calstar/iris-core-hw/README.md

View this project on [CADLAB.io](https://cadlab.io/project/23494). 

# iris-core-hw
