calstar/iris-core-hw/IRIS-core/IRIS_bom.xlsx

ITEM TO PURCHASE FROM DIGIKEY (IRIS CORE)
 | References | Digikey P/N | Value | Footprint | Quantity
1 | COR-BT1 | 36-500-ND | CR1220 - Keystone 500 | CR12XX-Keystone-500 | 1
2 | COR-C1 | 1276-1069-1-ND | 10pF | C_0603_1608Metric | 1
3 | COR-C2, COR-C6, COR-C7, COR-C8 | 1276-CL10B104KB8NNNLCT-ND | 0.1uF | C_0603_1608Metric | 4
4 | COR-C3 | 1276-1192-1-ND | 10uF | C_0603_1608Metric | 1
5 | COR-C4 | 478-10428-1-ND | 20nF | C_0805_2012Metric | 1
6 | COR-C5 | RMCF0603ZT0R00CT-ND | 0R | C_0603_1608Metric | 1
7 | COR-C9 | 1276-1102-1-ND | 1uF | C_0603_1608Metric | 1
8 | COR-D1, COR-D2 | MBR0540T3GOSCT-ND | MBR0540 | D_SOD-123 | 2
9 | COR-D3 | 732-4984-1-ND | 150080RS75000 | LED_0805_2012Metric_Pad1.15x1.40mm_HandSolder | 1
10 | COR-D4 | 732-4986-1-ND | 150080VS75000 | LED_0805_2012Metric_Pad1.15x1.40mm_HandSolder | 1
11 | COR-D5 | 732-4987-1-ND | 150080YS75000 | LED_0805_2012Metric_Pad1.15x1.40mm_HandSolder | 1
12 | COR-FB1 | 732-1593-1-ND | 600 | L_0603_1608Metric | 1
14 | COR-JP2 | 2057-PH1RB-02-UA-ND | Write_Protect | PinHeader_1x02_P2.54mm_Horizontal | 1
15 | COR-R1, COR-R2, COR-R5, COR-R6, COR-R11, COR-R12, COR-R13, COR-R14 | RNCP0603FTD10K0CT-ND | 10k | R_0603_1608Metric | 8
16 | COR-R10, COR-R20, COR-R21 | RMCF0603ZT0R00CT-ND | 0R | R_0603_1608Metric | 3
17 | COR-R15, COR-R16, COR-R17 | RMCF0603FT100RCT-ND | 100R | R_0603_1608Metric | 3
19 | COR-R3 | RMCF0603FT1K00CT-ND | 1k | R_0603_1608Metric | 1
20 | COR-R4 | P249BLCT-ND | 249R | R_0603_1608Metric | 1
21 | COR-R7, COR-R8 | RR08P100KDCT-ND | 100k | R_0603_1608Metric | 2
22 | COR-R9 | RR08P24.9KDCT-ND | 24.9k | R_0603_1608Metric | 1
23 | COR-SW1 | CKN9103-ND | SW_Push | SW_Tactile_SPST_Angled_PTS645Vx39-2LFS | 1
24 | COR-TP1 | 36-5006-ND | Raw | TestPoint_Keystone_5005-5009_Compact | 1
25 | COR-TP2 | 36-5006-ND | Amplified | TestPoint_Keystone_5005-5009_Compact | 1
29 | COR-U3 | LT1807IS8#TRPBFCT-ND | LT1807 | SOIC-8_3.9x4.9mm_P1.27mm | 1
30 | COR-U4 | 557-1789-ND | MT25QL01GBBB8ESF-0SIT | SOIC-16W_7.5x10.3mm_P1.27mm | 1
31 | COR-U5 | 1127-3597-ND | EVAL-ADXL372Z | EVAL-ADXL372Z | 1
33 | COR-U7, COR-U8, COR-U9 | 296-35965-1-ND | TPD4E1U06 | SOT-23-6 | 3
ITEM TO PURCHASE FROM DIGIKEY (IRIS POWER)
 | References | Digikey PN | Value | Footprint | Quantity
1 | C34, C71 | 1276-1102-1-ND | 1uF | C_0603_1608Metric | 2
2 | C31, C32, C33, C35, C41, C51, C52, C53, C54, C55, C56, C63, C72 | 1276-1192-1-ND | 10uF | C_0603_1608Metric | 13
3 | C43 | 1276-1814-1-ND | 68nF | C_0603_1608Metric | 1
4 | C44 | 1276-1951-1-ND | 1.2nF | C_0603_1608Metric | 1
5 | C45 | 1276-2025-1-ND | 27nF | C_0603_1608Metric | 1
6 | C65 | 1276-3063-1-ND | 47uF | C_1206_3216Metric | 1
7 | C46 | 1276-3387-1-ND | 10uF | C_0805_2012Metric | 1
8 | C21, C42, C64 | 1276-CL10B104KB8NNNLCT-ND | 0.1uF | C_0603_1608Metric | 3
9 | C61, C62 | 1572-DGH106Q2R7C-ND | 3.3F | CAP_10x27_5mm_pitch | 2
10 | C22, C47 | 587-3506-1-ND | 0.47uF | C_0603_1608Metric | 2
11 | R68 | 311-150KHRCT-ND | 150k | R_0603_1608Metric | 1
12 | R21 | 311-2595-1-ND | 499k | R_0603_1608Metric | 1
13 | R67 | 541-1.10MHCT-ND | 1.1M | R_0603_1608Metric | 1
14 | R25 | CST0612-FC-R002ECT-ND | 2m | CST0612-FC-R002E | 1
15 | R43 | P232KHCT-ND | 232k | R_0603_1608Metric | 1
16 | R65 | RMCF0603FG1M00CT-ND | 1M | R_0603_1608Metric | 1
17 | R32 | RMCF0603FT1K00CT-ND | 1k | R_0603_1608Metric | 1
18 | R35, R42 | RMCF0603FT38K3CT-ND | 38.3k | R_0603_1608Metric | 2
19 | R62, R66 | RMCF0603FT3K00CT-ND | 3k | R_0603_1608Metric | 2
20 | R64 | RMCF0603FT3M30CT-ND | 3.3M | R_0603_1608Metric | 1
21 | R24, R33, R44, R51, R61, R63, R69 | RNCP0603FTD10K0CT-ND | 10k | R_0603_1608Metric | 7
22 | R31, R34, R41, R52 | RNCP0603FTD2K49CT-ND | 2.49k | R_0603_1608Metric | 4
23 | R23 | RR08P200KDCT-ND | 200k | R_0603_1608Metric | 1
24 | R22 | RR08P301KDCT-ND | 301k | R_0603_1608Metric | 1
25 | L41 | 445-VLS6045AF-8R2MCT-ND | 8.2uH | VLS6045AF | 1
26 | L61 | 732-6178-1-ND | 1.5uH | 744316150 | 1
27 | D31, D41 | 641-1698-1-ND | D_Schottky | D_SMA_Handsoldering | 2
28 | U61 | Mail from Jason | LTC3110 | LTC3110 | 1
29 | U31 | Mail from Jason | TPS2121 | TPS2121 | 1
30 | U51 | From Mouser | TPSM53604 | TPSM53604 | 1
31 | U21 | 175-MAX17261METD+TCT-ND | MAX17261 | MAX17261 | 1
32 | U41 | Mail from Jason | TPS55340 | TPS55340 | 1
33 | U71 | 296-50414-1-ND | TLV75733PDBV | SOT-23-5 | 1
34 | U62 | 568-1837-1-ND | PCA9537 | TSSOP-10_3x3mm_P0.5mm | 1
35 | JP41, JP42 |  | Jumper_3_Bridged12 | PinHeader_1x03_P2.54mm_Vertical | 2
37 | Q21 | 1727-8643-1-ND | 2N7002 | SOT-23 | 1
38 | TP61 | 36-5006-ND | Vcap | TestPoint_Keystone_5000-5004_Miniature | 1
39 | TP101 | 36-5006-ND | Jack | TestPoint_Keystone_5000-5004_Miniature | 1
40 | TP102 | 36-5006-ND | Mux | TestPoint_Keystone_5000-5004_Miniature | 1
41 | TP103 | 36-5006-ND | #NAME? | TestPoint_Keystone_5000-5004_Miniature | 1
42 | TP104 | 36-5006-ND | 5V | TestPoint_Keystone_5000-5004_Miniature | 1
43 | TP105 | 36-5006-ND | 29.5V | TestPoint_Keystone_5000-5004_Miniature | 1
44 | TP106 | 36-5006-ND | Backup | TestPoint_Keystone_5000-5004_Miniature | 1
45 | TP107 | 36-5006-ND | 3.3V | TestPoint_Keystone_5000-5004_Miniature | 1
46 | Q61 | DMP2066LSNDICT-ND | DMP2066LSN-7 | SOT-23 | 1
47 | J11 | 2243-1336G1-ND | Powerpole | Powerpole_1336G1 | 1
48 | J12 | CP-047AH-ND | PJ-047AH | CUI_PJ-047AH | 1
ITEMS TO PURCHASE FROM OTHER VENDOR
 | U2 | https://www.tindie.com/products/onehorse/all-st-motion-sensor-breakout-board/ | ST_MOTION_Breakout |  | 1
Connectors to Purchase / Sample
 | Part Number | Digikey P/N | Mouser P/N | Notes | Quantity
 | TLW-105-06-T-S | SAM1101-05-ND |  | 2 for ADXL372 board, 2 for IMU breakout, 2 for Teensy 4.1 | 6
 | SLW-105-01-T-S | SAM1093-05-ND |  | 2 for ADXL372 board, 2 for IMU breakout, 2 for Teensy 4.1 | 6
 | SSW-103-01-G-D | SAM1208-03-ND |  | 2 for 2 scintillator boards | 2
 | TLW-124-06-T-S |  | 200-TLW12406TS | Recommend sample from samtec, 4 for Teensy 4.1 | 4
 | SLW-124-01-T-S | SAM1093-24-ND |  | 4 for Teensy 4.1 (2 teensy for 2 boards?) | 4
 | ESQ-120-24-T-S |  | 200-ESQ12024TS | 1 for middle board | 1
 | TSW-120-18-L-S |  | 200-TSW12018LS | 1 for top board | 1
 | SSW-120-02-G-S |  | 200-SSW12002GS | 1 for bottom board | 1
