calstar/iris-core-hw/IRIS-core/IRIS-core.kicad_pcb

## KiCad design IRIS-core/IRIS-core.kicad_pcb (2020-11-06)

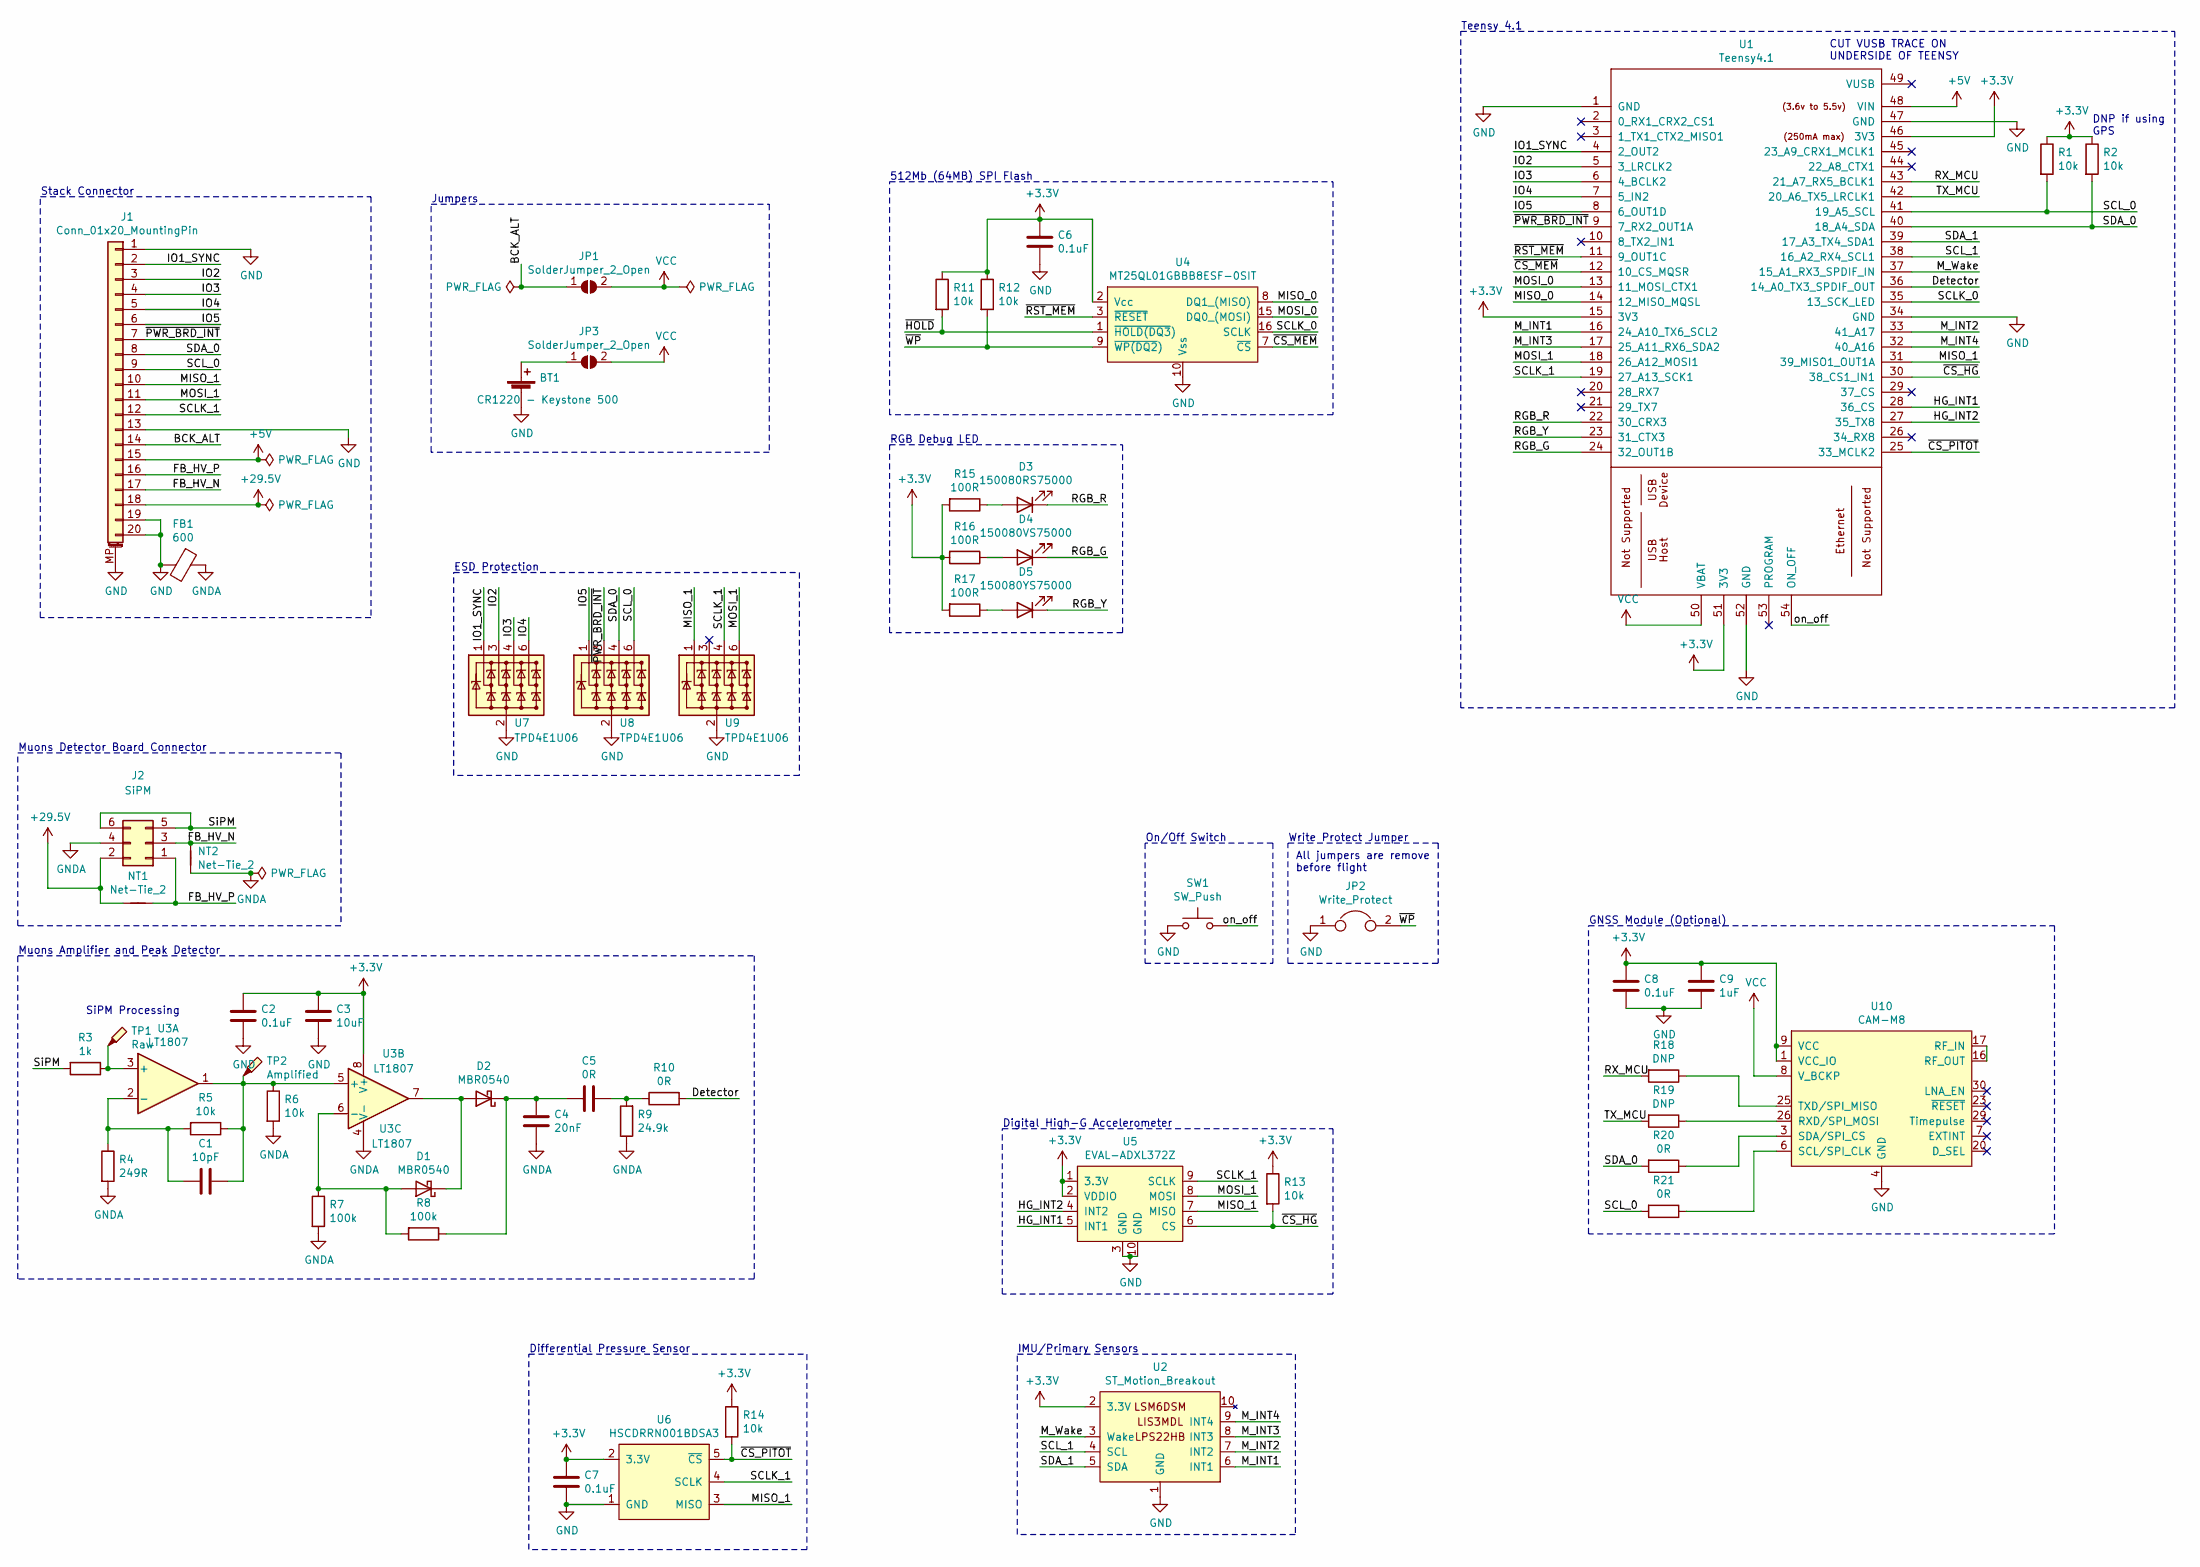
[picture p1: schematic IRIS-core.sch]

Parts:
BT1: CR1220 - Keystone 500; CR12XX-Keystone-500; Digikey P/N 36-500-ND
C1: 10pF; C_0603_1608Metric; Digikey P/N 1276-1069-1-ND
C2, C6, C7, C8: 0.1uF; C_0603_1608Metric; Digikey P/N 1276-CL10B104KB8NNNLCT-ND
C3: 10uF; C_0603_1608Metric; Digikey P/N 1276-1192-1-ND
C4: 20nF; C_0805_2012Metric; Digikey P/N 478-10428-1-ND
C5: 0R; C_0603_1608Metric; Digikey P/N RMCF0603ZT0R00CT-ND
C9: 1uF; C_0603_1608Metric; Digikey P/N 1276-1102-1-ND
D1, D2: MBR0540; D_SOD-123; Digikey P/N MBR0540T3GOSCT-ND
D3: 150080RS75000; LED_0805_2012Metric_Pad1.15x1.40mm_HandSolder; Digikey P/N 732-4984-1-ND
D4: 150080VS75000; LED_0805_2012Metric_Pad1.15x1.40mm_HandSolder; Digikey P/N 732-4986-1-ND
D5: 150080YS75000; LED_0805_2012Metric_Pad1.15x1.40mm_HandSolder; Digikey P/N 732-4987-1-ND
FB1: 600; L_0603_1608Metric; Digikey P/N 732-1593-1-ND
J1: Conn_01x20_MountingPin; IRIS_Muons_physical
J2: SiPM
JP1, JP3: SolderJumper_2_Open; SolderJumper-2_P1.3mm_Open_RoundedPad1.0x1.5mm
JP2: Write_Protect; PinHeader_1x02_P2.54mm_Horizontal; Digikey P/N 2057-PH1RB-02-UA-ND
NT1, NT2: Net-Tie_2; NetTie-2_SMD_Pad0.5mm
R1, R2, R5, R6, R11, R12, R13, R14: 10k; R_0603_1608Metric; Digikey P/N RNCP0603FTD10K0CT-ND
R3: 1k; R_0603_1608Metric; Digikey P/N RMCF0603FT1K00CT-ND
R4: 249R; R_0603_1608Metric; Digikey P/N P249BLCT-ND
R7, R8: 100k; R_0603_1608Metric; Digikey P/N RR08P100KDCT-ND
R9: 24.9k; R_0603_1608Metric; Digikey P/N RR08P24.9KDCT-ND
R10, R20, R21: 0R; R_0603_1608Metric; Digikey P/N RMCF0603ZT0R00CT-ND
R15, R16, R17: 100R; R_0603_1608Metric; Digikey P/N RMCF0603FT100RCT-ND
R18, R19: DNP; R_0603_1608Metric
SW1: SW_Push; SW_Tactile_SPST_Angled_PTS645Vx39-2LFS; Digikey P/N CKN9103-ND
TP1: Raw; TestPoint_Keystone_5005-5009_Compact; Digikey P/N 36-5006-ND
TP2: Amplified; TestPoint_Keystone_5005-5009_Compact; Digikey P/N 36-5006-ND
U1: Teensy4.1; Teensy41
U2: ST_Motion_Breakout
U3: LT1807; SOIC-8_3.9x4.9mm_P1.27mm; Digikey P/N LT1807IS8#TRPBFCT-ND
U4: MT25QL01GBBB8ESF-0SIT; SOIC-16W_7.5x10.3mm_P1.27mm; Digikey P/N 557-1789-ND
U5: EVAL-ADXL372Z; Digikey P/N 1127-3597-ND
U6: HSCDRRN001BDSA3
U7, U8, U9: TPD4E1U06; SOT-23-6; Digikey P/N 296-35965-1-ND
U10: CAM-M8; UBLOX_CAM_M8; Digikey P/N 672-CAM-M8Q-0TR-ND

Connections:
+3V3: C2.1, C3.1, C6.1, C7.1, C8.1, C9.1, R1.1, R2.1, R11.1, R12.1, R13.1, R14.1, R15.2, R16.2, R17.2, U1.15 (3V3), U1.46 (3V3), U1.51 (3V3), U2.2 (3.3V), U3.8 (V+), U4.2 (Vcc), U5.1 (3.3V), U5.2 (VDDIO), U6.2 (3.3V), U10.1 (VCC_IO), U10.9 (VCC)
+5V: J1.15, U1.48 (VIN)
+29.5V: J1.18, J2.2, NT1.2
/BCK_ALT: J1.14, JP1.1 (A)
/Detector: R10.2, U1.36 (14_A0_TX3_SPDIF_OUT)
/FB_HV_N: J1.17, J2.3, NT2.1
/FB_HV_P: J1.16, J2.1, NT1.1
/HG_INT1: U1.28 (36_CS), U5.5 (INT1)
/HG_INT2: U1.27 (35_TX8), U5.4 (INT2)
/IO1_SYNC: J1.2, U1.4 (2_OUT2), U7.1 (IO1)
/IO2: J1.3, U1.5 (3_LRCLK2), U7.3 (IO2)
/IO3: J1.4, U1.6 (4_BCLK2), U7.4 (IO3)
/IO4: J1.5, U1.7 (5_IN2), U7.6 (IO4)
/IO5: J1.6, U1.8 (6_OUT1D), U8.1 (IO1)
/MISO_0: U1.14 (12_MISO_MQSL), U4.8 (DQ1_(MISO))
/MISO_1: J1.10, U1.31 (39_MISO1_OUT1A), U5.7 (MISO), U6.3 (MISO), U9.1 (IO1)
/MOSI_0: U1.13 (11_MOSI_CTX1), U4.15 (DQ0_(MOSI))
/MOSI_1: J1.11, U1.18 (26_A12_MOSI1), U5.8 (MOSI), U9.6 (IO4)
/M_INT1: U1.16 (24_A10_TX6_SCL2), U2.6 (INT1)
/M_INT2: U1.33 (41_A17), U2.7 (INT2)
/M_INT3: U1.17 (25_A11_RX6_SDA2), U2.8 (INT3)
/M_INT4: U1.32 (40_A16), U2.9 (INT4)
/M_Wake: U1.37 (15_A1_RX3_SPDIF_IN), U2.3 (Wake)
/RGB_G: D4.1 (K), U1.24 (32_OUT1B)
/RGB_R: D3.1 (K), U1.22 (30_CRX3)
/RGB_Y: D5.1 (K), U1.23 (31_CTX3)
/RX_MCU: R18.2, U1.43 (21_A7_RX5_BCLK1)
/SCLK_0: U1.35 (13_SCK_LED), U4.16 (SCLK)
/SCLK_1: J1.12, U1.19 (27_A13_SCK1), U5.9 (SCLK), U6.4 (SCLK), U9.4 (IO3)
/SCL_0: J1.9, R1.2, R21.2, U1.41 (19_A5_SCL), U8.6 (IO4)
/SCL_1: U1.38 (16_A2_RX4_SCL1), U2.4 (SCL)
/SDA_0: J1.8, R2.2, R20.2, U1.40 (18_A4_SDA), U8.4 (IO3)
/SDA_1: U1.39 (17_A3_TX4_SDA1), U2.5 (SDA)
/SiPM: J2.5, J2.6, R3.2
/TX_MCU: R19.2, U1.42 (20_A6_TX5_LRCLK1)
/on_off: SW1.2, U1.54 (ON_OFF)
/~CS_HG: R13.2, U1.30 (38_CS1_IN1), U5.6 (CS)
/~CS_MEM: U1.12 (10_CS_MQSR), U4.7 (~CS)
/~CS_PITOT: R14.2, U1.25 (33_MCLK2), U6.5 (~CS)
/~HOLD: R11.2, U4.1 (~HOLD(DQ3))
/~PWR_BRD_INT: J1.7, U1.9 (7_RX2_OUT1A), U8.3 (IO2)
/~RST_MEM: U1.11 (9_OUT1C), U4.3 (~RESET)
/~WP: JP2.2, R12.2, U4.9 (~WP(DQ2))
GND: BT1.2 (-), C2.2, C3.2, C6.2, C7.2, C8.2, C9.2, FB1.2, J1.1, J1.13, J1.19, J1.20, J1.MP (MountPin), JP2.1, SW1.1, U1.1 (GND), U1.34 (GND), U1.47 (GND), U1.52 (GND), U2.1 (GND), U4.10 (Vss), U5.3 (GND), U5.10 (GND), U6.1 (GND), U7.2 (GND), U8.2 (GND), U9.2 (GND), U10.4 (GND), U10.5 (GND), U10.10 (GND), U10.11 (GND), U10.12 (GND), U10.13 (GND), U10.14 (GND), U10.15 (GND), U10.18 (GND), U10.19 (GND), U10.21 (GND), U10.22 (GND), U10.27 (GND), U10.31 (GND)
GNDA: C4.2, FB1.1, J2.4, NT2.2, R4.2, R6.2, R7.2, R9.1, U3.4 (V-)
unnamed: BT1.1 (+), JP3.1 (A)
unnamed: C1.1, R5.1, R6.1, TP2.1, U3.1, U3.5 (+)
unnamed: C1.2, R4.1, R5.2, U3.2 (-)
unnamed: C4.1, C5.2, D2.1 (K), R8.1
unnamed: C5.1, R9.2, R10.1
unnamed: D1.1 (K), D2.2 (A), U3.7
unnamed: D1.2 (A), R7.1, R8.2, U3.6 (-)
unnamed: D3.2 (A), R15.1
unnamed: D4.2 (A), R16.1
unnamed: D5.2 (A), R17.1
unnamed: R3.1, TP1.1, U3.3 (+)
unnamed: R18.1, U10.25 (TXD/SPI_MISO)
unnamed: R19.1, U10.26 (RXD/SPI_MOSI)
unnamed: R20.1, U10.3 (SDA/SPI_CS)
unnamed: R21.1, U10.6 (SCL/SPI_CLK)
unnamed: U10.16 (RF_OUT), U10.17 (RF_IN)
VCC: JP1.2 (B), JP3.2 (B), U1.50 (VBAT), U10.8 (V_BCKP)

Notes on the sheet:
Digital High-G Accelerometer
512Mb (64MB) SPI Flash
IMU/Primary Sensors
RGB Debug LED
SiPM Processing
CUT VUSB TRACE ON UNDERSIDE OF TEENSY
All jumpers are remove before flight
DNP if using GPS
Teensy 4.1
GNSS Module (Optional)
Differential Pressure Sensor
Muons Amplifier and Peak Detector
Muons Detector Board Connector
Jumpers
Write Protect Jumper
ESD Protection
On/Off Switch
Stack Connector

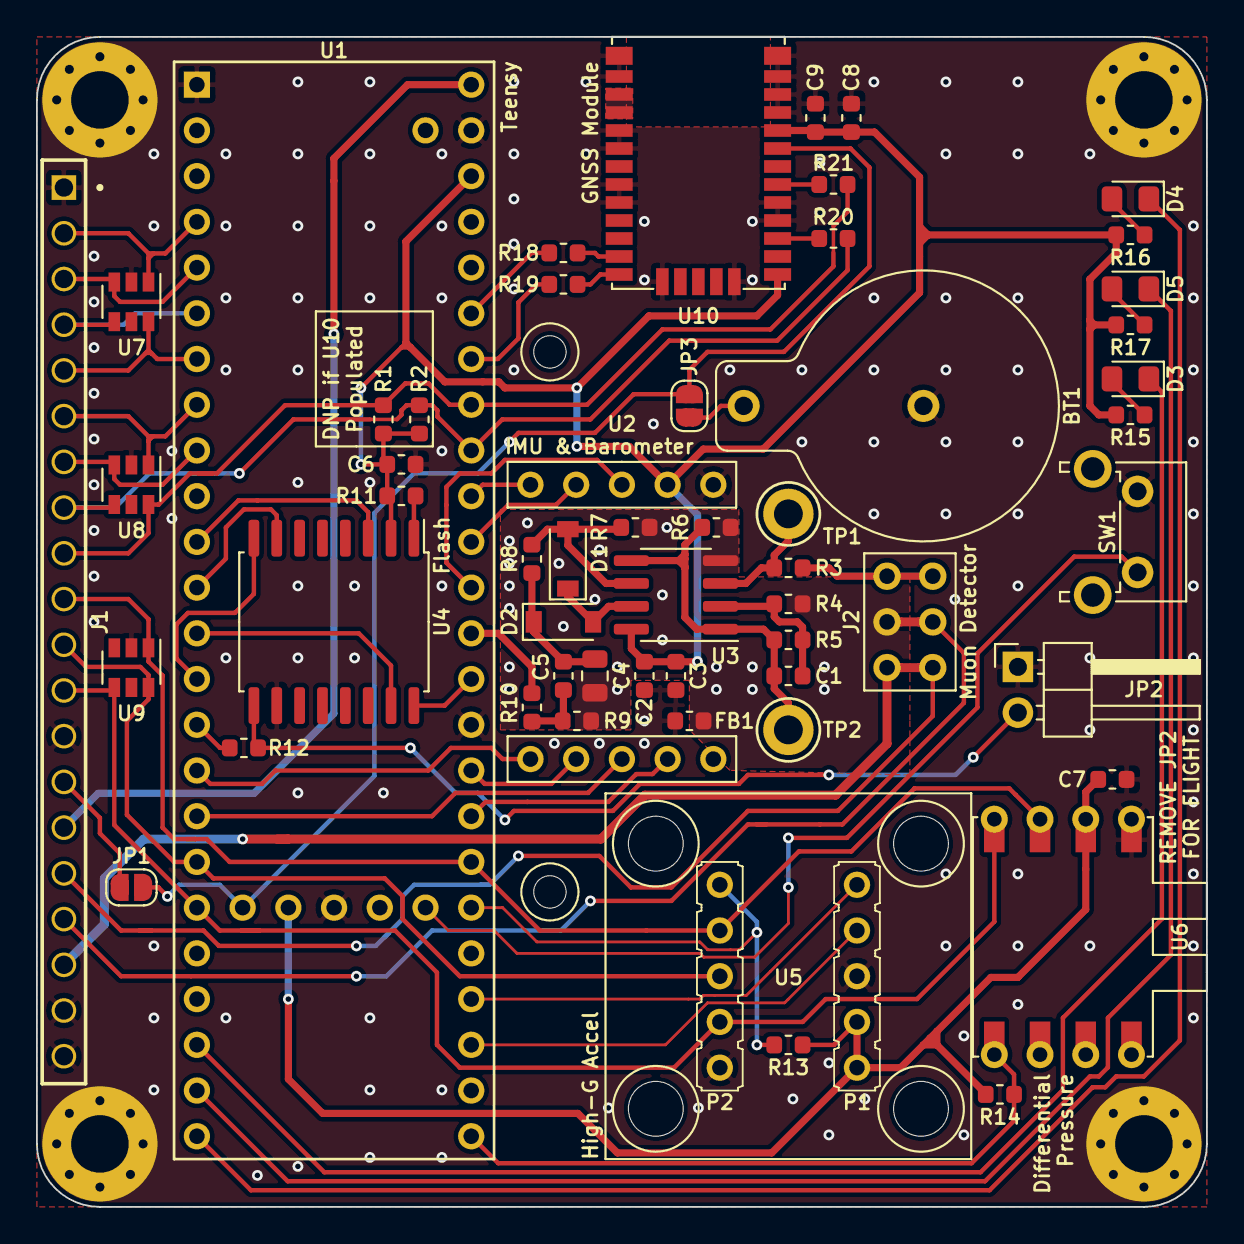
[picture p2: board IRIS-core.kicad_pcb from above]

Board: 2 copper layers, 65.0 x 65.0 mm, 57 parts (0 on the bottom side), 62 nets.
