calstar/iris-core-hw/(commit log)

2020-08-31 Added ESP32
    [IRIS-core.kicad_pcb, IRIS-core.sch]
2020-10-13 IRIS Core V4.0 draft
    [IRIS-core.kicad_pcb, IRIS-core.sch]
2020-11-06 Added BOM, IRIS core ready for review
    [IRIS-core.kicad_pcb, IRIS-core.sch]
2021-01-27 IRIS Core
    [IRIS-core-B_Cu.gbr, IRIS-core-B_Mask.gbr, IRIS-core-B_SilkS.gbr, IRIS-core-Edge_Cuts.gbr, IRIS-core-F_Cu.gbr, IRIS-core-F_Mask.gbr, IRIS-core-F_SilkS.gbr, IRIS-core-NPTH.drl]
